specialKody/Mobile-Waterway-Monitor/Thesis/Images/Node/Node_Water_Top.jpg

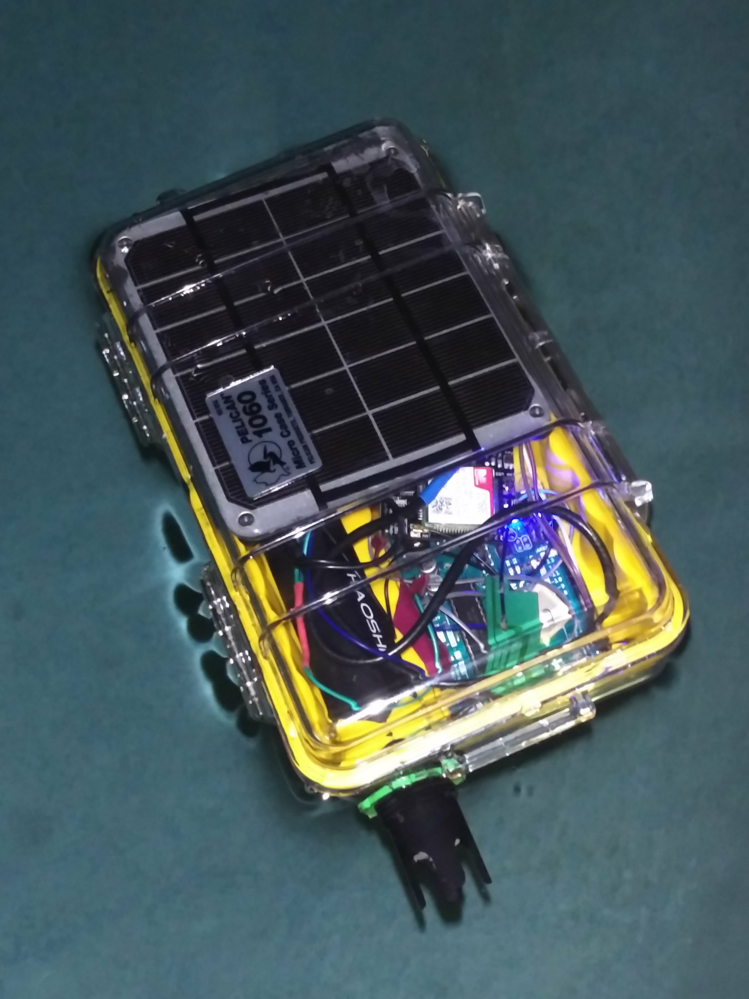
Thesis/Images/Node/Node_Water_Top.jpg
