specialKody/Mobile-Waterway-Monitor/Thesis/Images/Node/Node_Top.jpg

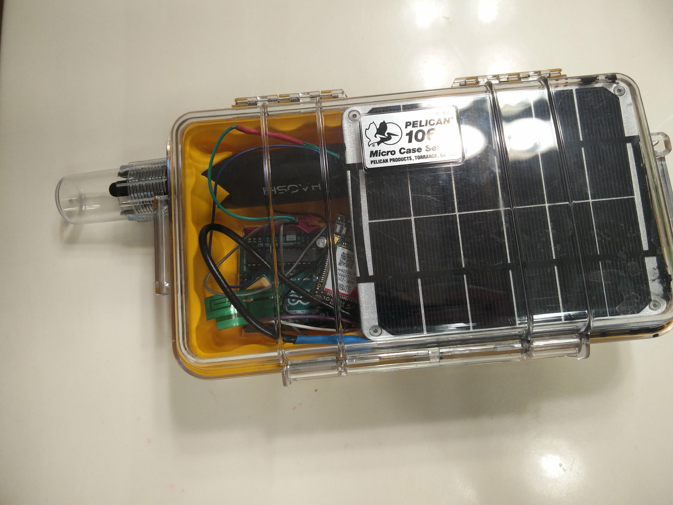
Thesis/Images/Node/Node_Top.jpg
