specialKody/Mobile-Waterway-Monitor/README.md

# Mobile-Waterway-Monitor
Small floating IoT device which follows waterway current while transmitting live data
