specialKody/Mobile-Waterway-Monitor/Resources/Single Iterative Processes Proposal.docx

# Single Iterative Process

Kody Stribrny

# Overview

The Single Iterative Process (SIP) discussed in the book Software Engineering: The Current Practice discusses a strategy for a single programmer to successfully manage resources for smaller scale projects with several stakeholders. This process requires documentation of bugs, features to be implemented, and changes. The process also stresses planning which should prove invaluable if the project cannot be completed.

### Implementable Features

#### Code Size Based Metrics

The chapter mentions that as lines of code are added the complexity of a program increases. A useful metric would be to keep track of the number of lines of code at each meeting or when bugs are found. This would help show the development process to outside viewers.

#### Defect Logs

Keeping track of when defects were found and fixed will help explain why progress on any given day might not appear to be significant while in reality it was. I need to create a document for recording the defects I stumble upon.

#### Phases and Baselines

I have planned out most of the phases for the project in my prospectus schedule. I haven’t planned for any baselines. It would probably be advisable to check in a project baseline weekly. If I follow this planning goal, then I will be more structured in my development. I will use GitHub to store my baselines and will release baseline notes which accompany them. The notes should document the newly implemented features as well as the defect logs and current line count.
