specialKody/Mobile-Waterway-Monitor/Thesis/Images/Adafruit IO/Battery Feed.JPG

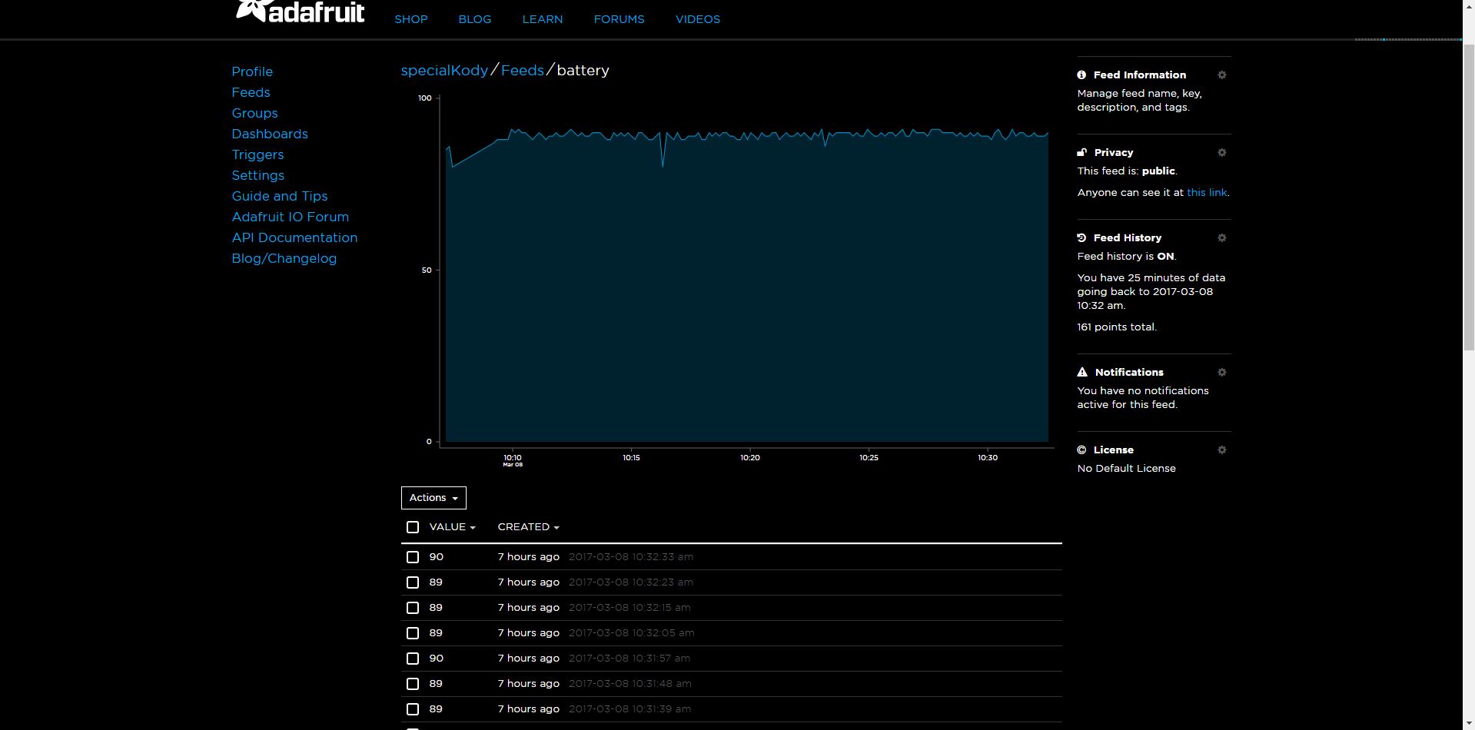
Thesis/Images/Adafruit IO/Battery Feed.JPG
