specialKody/Mobile-Waterway-Monitor/Thesis/Images/Adafruit IO/Dashboard Options.JPG

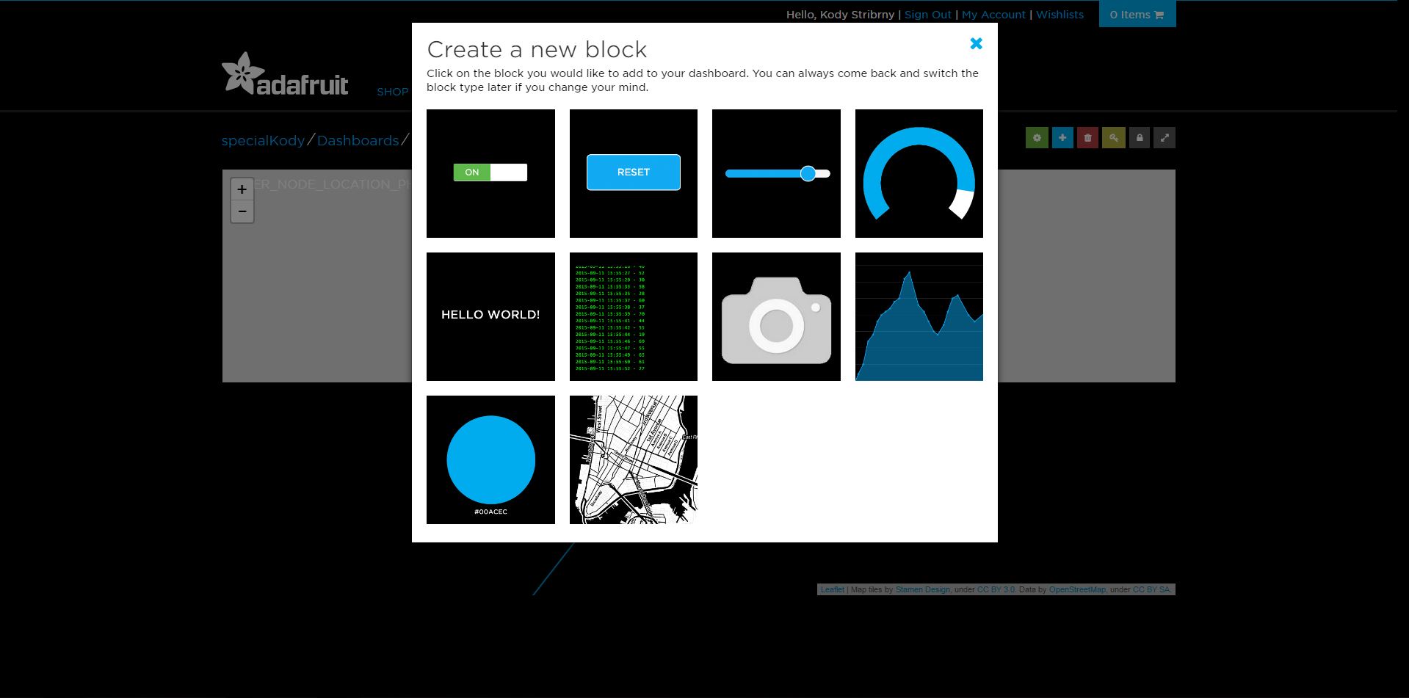
Thesis/Images/Adafruit IO/Dashboard Options.JPG
