specialKody/Mobile-Waterway-Monitor/Thesis/Images/Adafruit IO/Dashboard Welcome.JPG

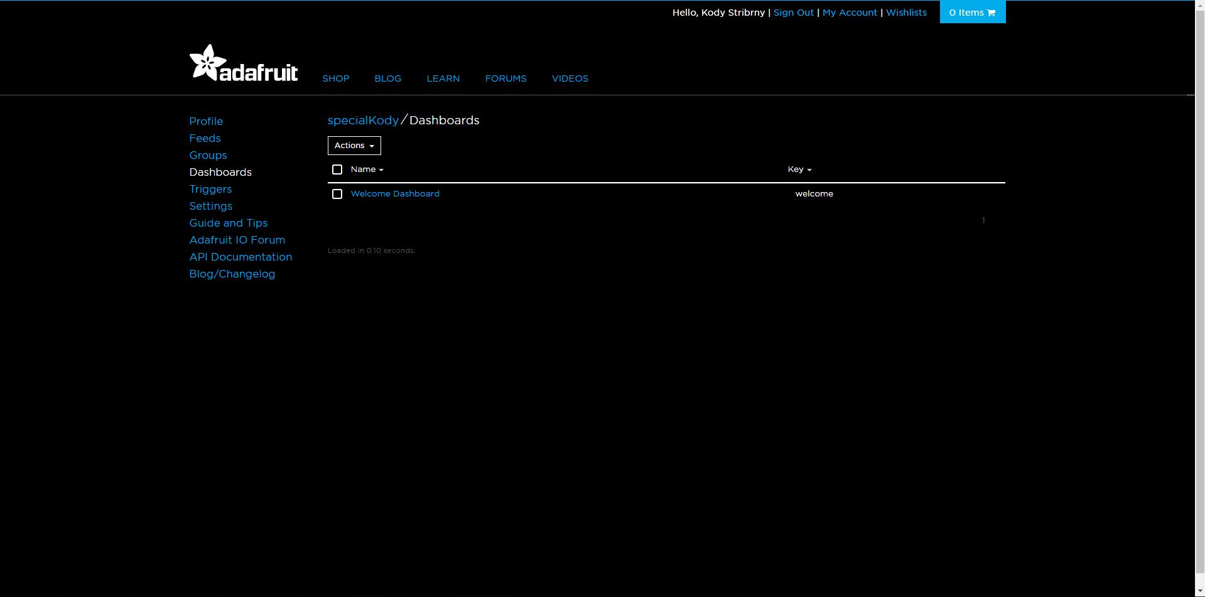
Thesis/Images/Adafruit IO/Dashboard Welcome.JPG
