specialKody/Mobile-Waterway-Monitor/Thesis/Images/Adafruit IO/Feed Actions.JPG

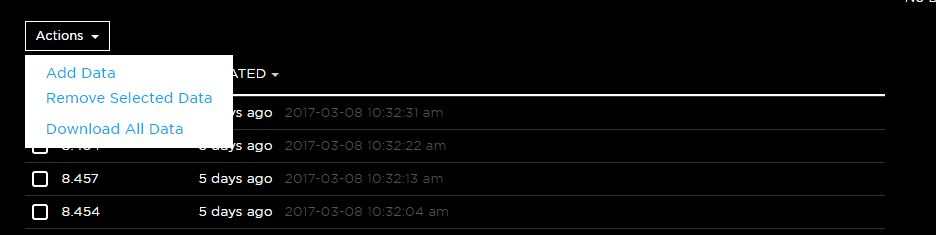
Thesis/Images/Adafruit IO/Feed Actions.JPG
