specialKody/Mobile-Waterway-Monitor/Thesis/Images/Adafruit IO/Feed Export.JPG

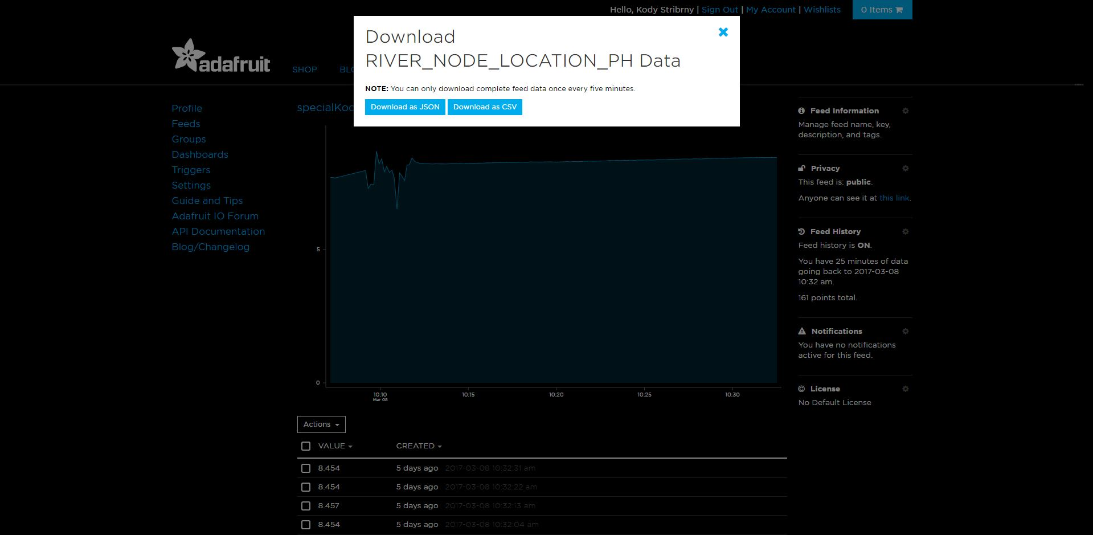
Thesis/Images/Adafruit IO/Feed Export.JPG
