specialKody/Mobile-Waterway-Monitor/Thesis/Images/Adafruit IO/Feed Options.JPG

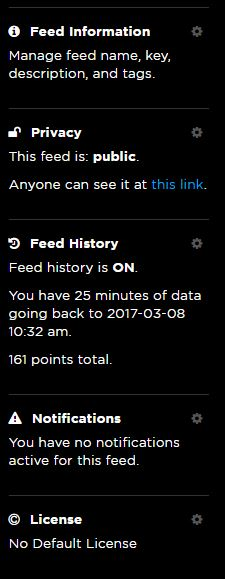
Thesis/Images/Adafruit IO/Feed Options.JPG
