specialKody/Mobile-Waterway-Monitor/Thesis/Images/Adafruit IO/Feeds Welcome.JPG

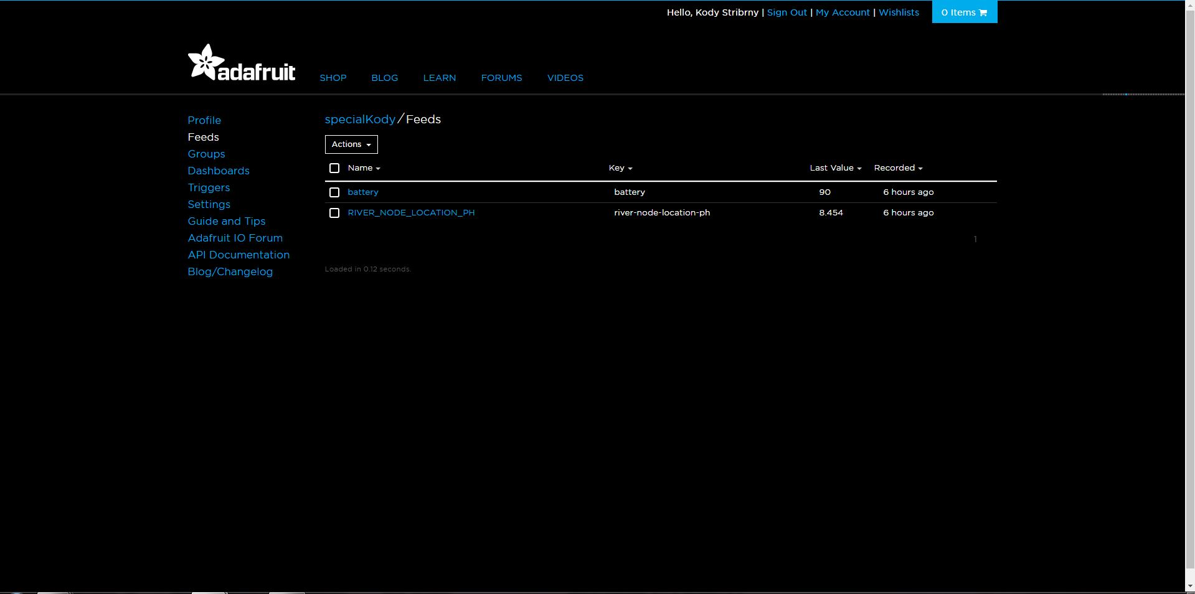
Thesis/Images/Adafruit IO/Feeds Welcome.JPG
