specialKody/Mobile-Waterway-Monitor/Thesis/Images/Document Images/Barrett_Honors_College.jpg

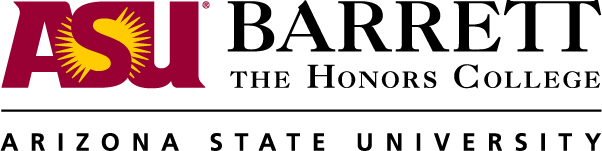
Thesis/Images/Document Images/Barrett_Honors_College.jpg
