specialKody/Mobile-Waterway-Monitor/Thesis/Images/Document Images/GSM_SIM_card_evolution.svg.png

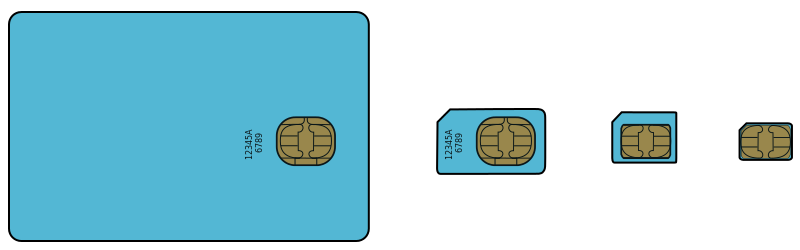
Thesis/Images/Document Images/GSM_SIM_card_evolution.svg.png
