specialKody/Mobile-Waterway-Monitor/Thesis/Images/Document Images/pH probe.png

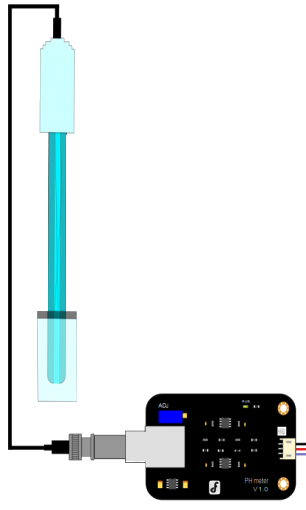
Thesis/Images/Document Images/pH probe.png
