specialKody/Mobile-Waterway-Monitor/Thesis/Images/Live Demo/Node Moving.jpg

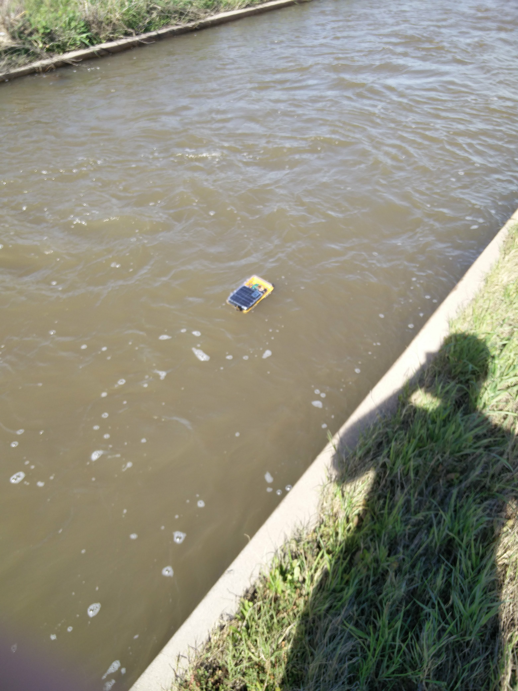
Thesis/Images/Live Demo/Node Moving.jpg
