specialKody/Mobile-Waterway-Monitor/Thesis/Images/Node/Node_Opened.jpg

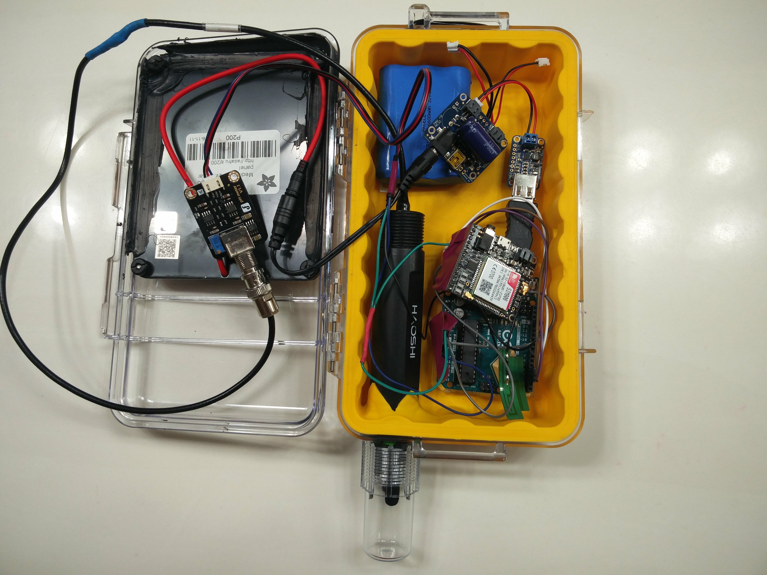
Thesis/Images/Node/Node_Opened.jpg
