specialKody/Mobile-Waterway-Monitor/Thesis/Images/Node/Node_Side.jpg

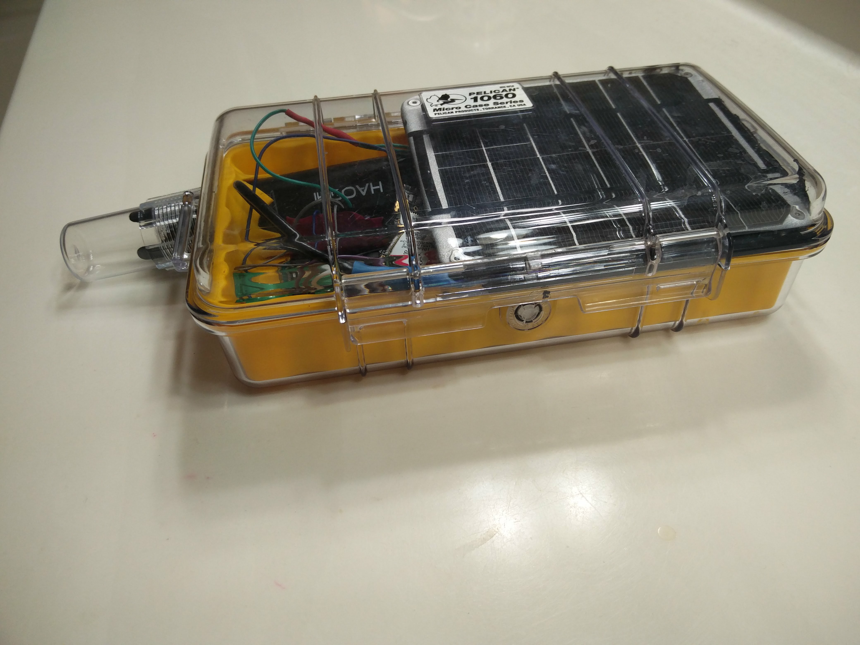
Thesis/Images/Node/Node_Side.jpg
