specialKody/Mobile-Waterway-Monitor/Thesis/Images/Node/Node_Water_Side.jpg

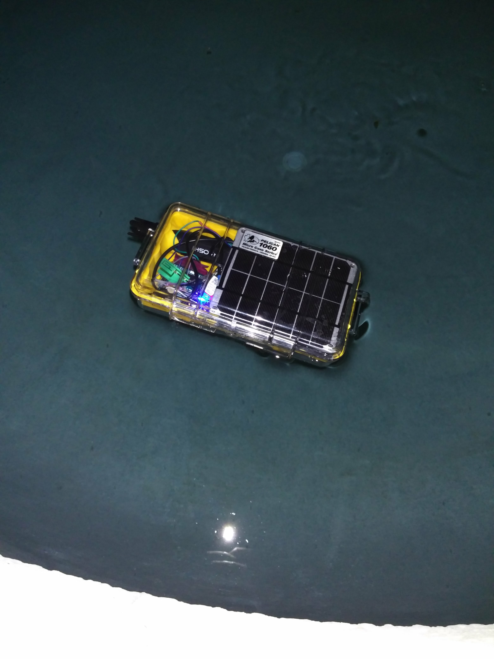
Thesis/Images/Node/Node_Water_Side.jpg
