specialKody/Mobile-Waterway-Monitor/Thesis/Images/Node/pH meter seal side.jpg

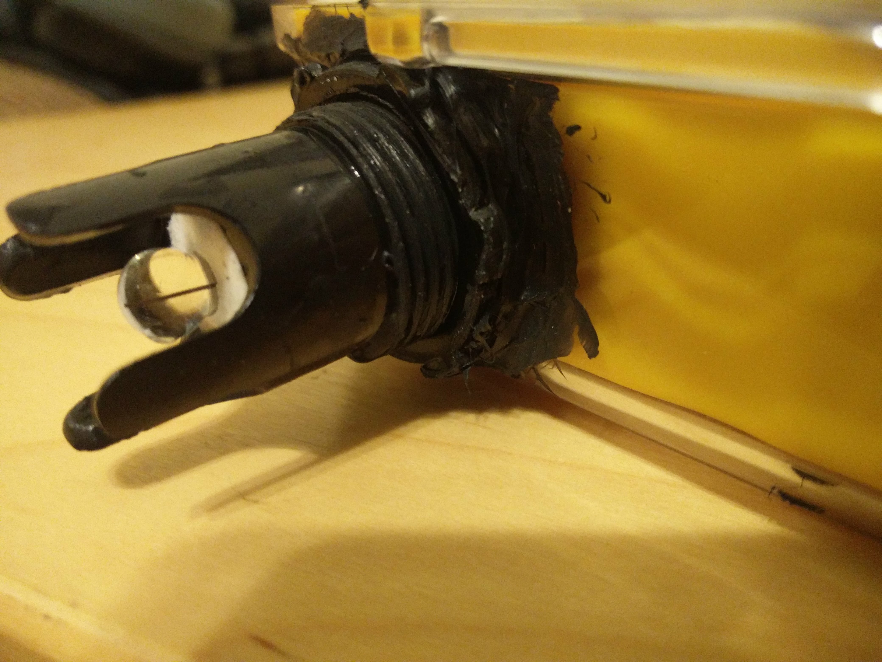
Thesis/Images/Node/pH meter seal side.jpg
