specialKody/Mobile-Waterway-Monitor/Thesis/Images/Node/pH meter seal.jpg

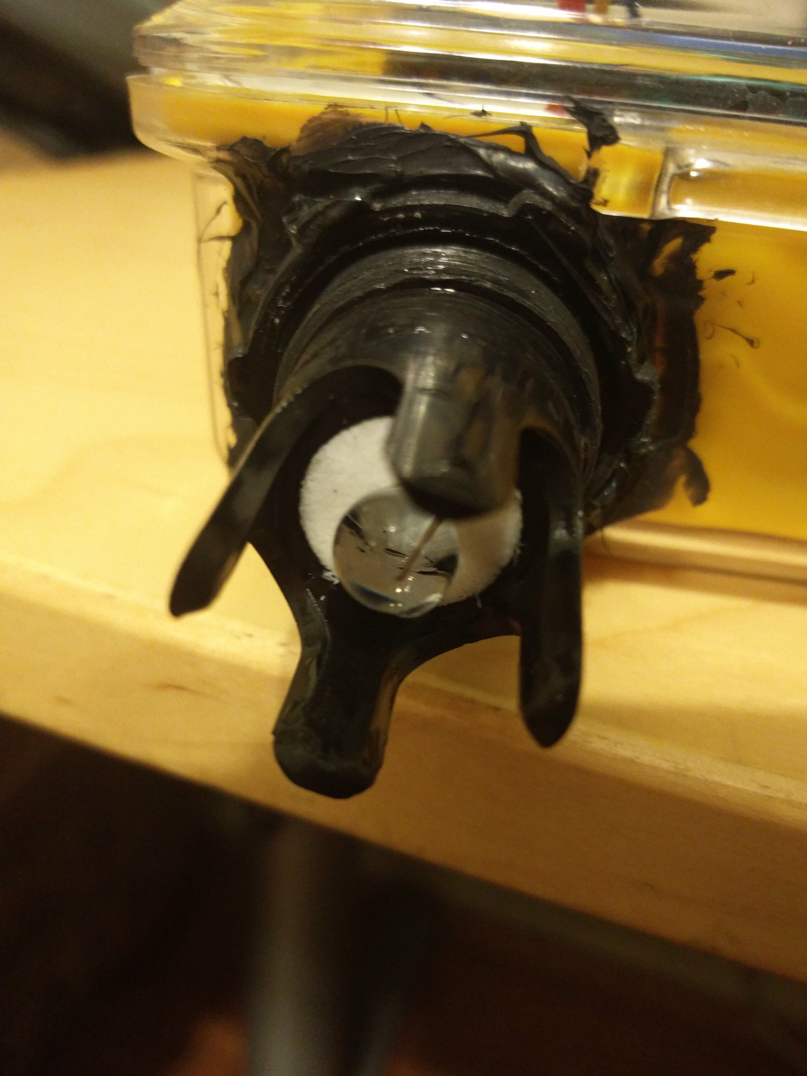
Thesis/Images/Node/pH meter seal.jpg
