specialKody/Mobile-Waterway-Monitor/Thesis/Images/Python Dashboard/Combined Plot.JPG

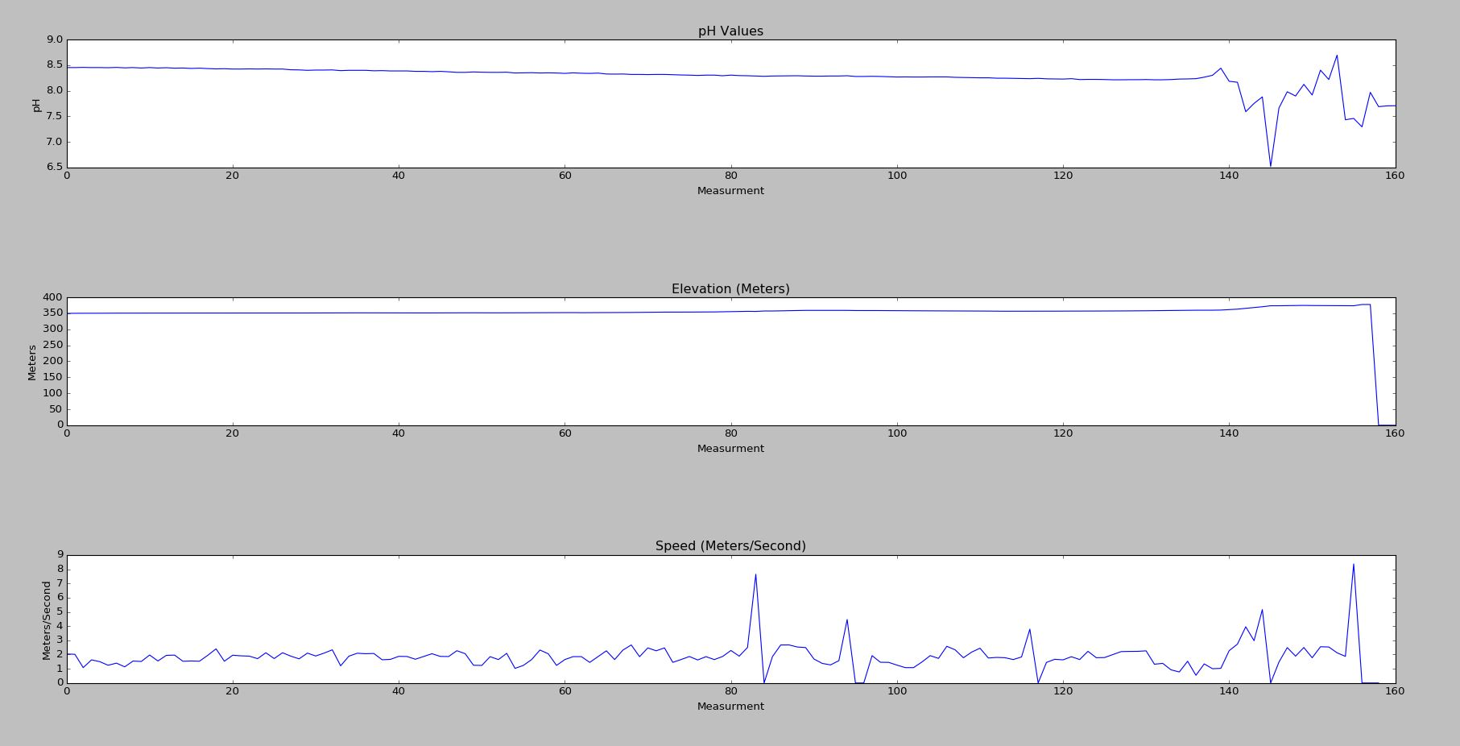
Thesis/Images/Python Dashboard/Combined Plot.JPG
