specialKody/Mobile-Waterway-Monitor/Thesis/Images/Python Dashboard/Dasbhoard Export.JPG

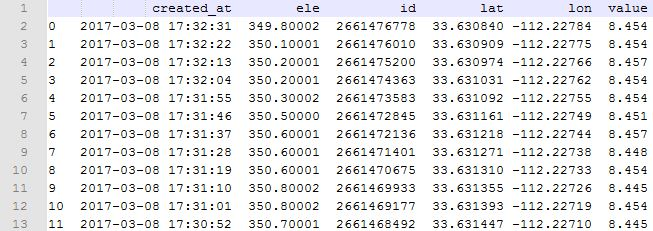
Thesis/Images/Python Dashboard/Dasbhoard Export.JPG
