specialKody/Mobile-Waterway-Monitor/Thesis/Images/Python Dashboard/Dashboard Execution.JPG

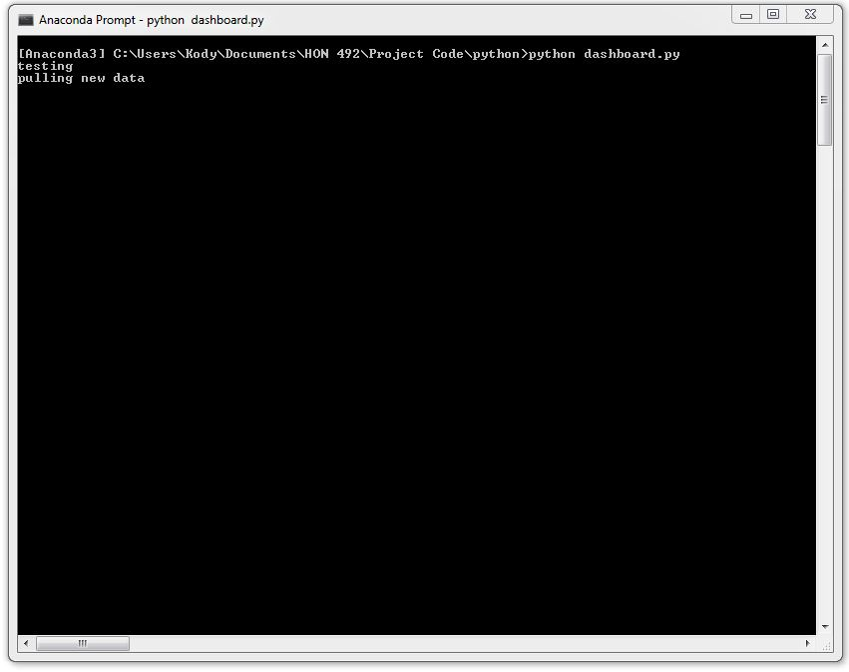
Thesis/Images/Python Dashboard/Dashboard Execution.JPG
