specialKody/Mobile-Waterway-Monitor/Thesis/Images/Python Dashboard/PH Map Expanded.JPG

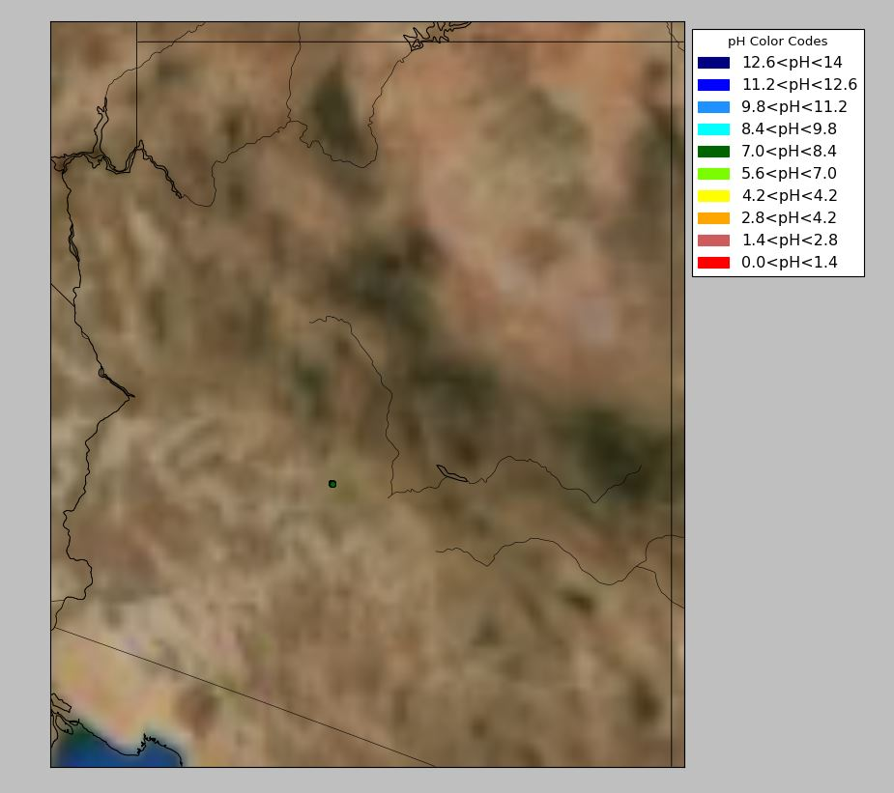
Thesis/Images/Python Dashboard/PH Map Expanded.JPG
