specialKody/Mobile-Waterway-Monitor/Thesis/Images/Python Dashboard/PH Map High Color Contrast.JPG

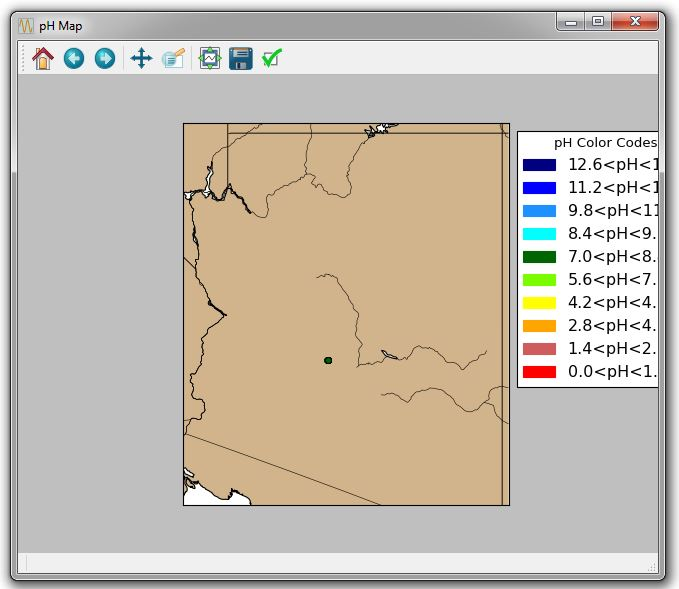
Thesis/Images/Python Dashboard/PH Map High Color Contrast.JPG
