specialKody/Mobile-Waterway-Monitor/Thesis/Images/Python Dashboard/PH Map High Level.JPG

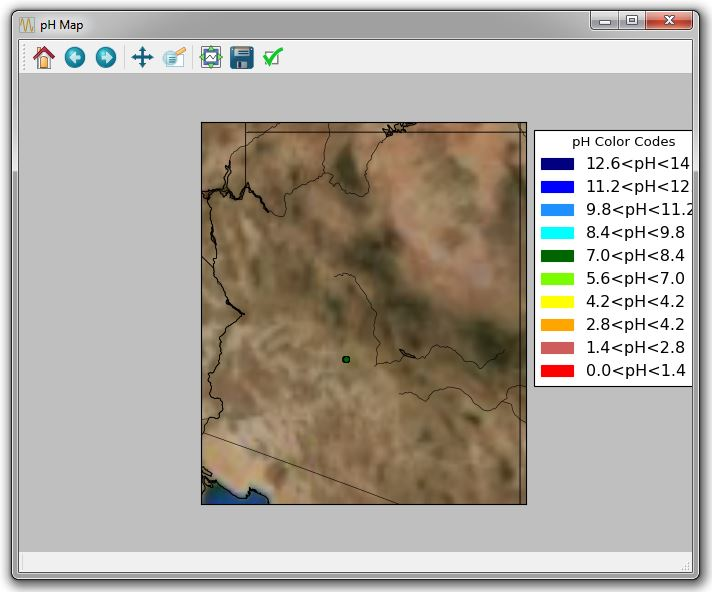
Thesis/Images/Python Dashboard/PH Map High Level.JPG
