specialKody/Mobile-Waterway-Monitor/Thesis/Images/Python Dashboard/PH Plot High Contrast.JPG

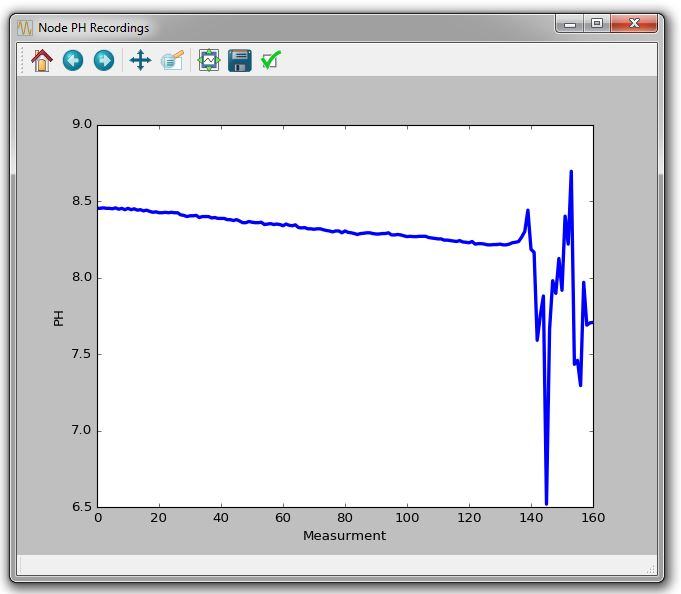
Thesis/Images/Python Dashboard/PH Plot High Contrast.JPG
